ENACRobotique/Cartes_Base_roulante/README.md

# Carte_Base_roulante_2024
Carte custom pour une base roulante holonome basé sur la STM32G484Retx
Conçue pour d'elle même faire de l'odométrie par encodeur et gyroscope.
Le debug nécéssite une sonde externe.
