ENACRobotique/Cartes_Base_roulante/Brushless/Composants.md

## Liste de composants Brushless (avec références RS)

### Capacités:
- **0603** :
  - 100n x8
  - 4.7u
  - 10n
  - 470n
  - 1u x2
  - 10u x 4 : 766-1104
- **100u** : 135-9884

### Résistances:
- **0805** :
  - 120 x2
  - 10k x2
  - 53k
  - osef x3 (R-LED)
  - 40k
- **0603** :
  - 5.1k x2

### Diodes:
- **Diode SOD 123W x3** : Nexperia_CFP3_SOD-123W
- **LED 0603 x2** : LED_0603_1608Metric_Pad1.05x0.95mm_HandSolder
- **LED 0603**
- **Zener SOD 523**

### Quartz:
- **ASCO** : [rs 171-2862](https://fr.rs-online.com/web/p/oscillateurs-a-quartz/1712862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) [fn 3573056](https://fr.farnell.com/abracon/asco-8-000mhz-ek-t3/oscillateur-8mhz-cmos-1-6mm-x/dp/3573056)

### MOSFET:
- **IRF7424PbF SOIC-8 (or IRF7404PbF)** : [178-1525](https://fr.rs-online.com/web/p/transistors-mosfet/1781525) !!! [OBSOLETE](https://www.mouser.fr/ProductDetail/Infineon-Technologies/IRF7404PBF?qs=viZOYRqmkgHi8AOJUtYoMQ%3D%3D) !!!

### Autres composants:
- **Bouton** : [378-6325](https://fr.rs-online.com/web/p/interrupteurs-tactiles/3786325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)
- **IMU** : LSM6DSL - [1639811](https://fr.rs-online.com/web/p/capteurs-de-mouvement/1639811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)

### Transformateurs :
- **LM3940IMP-3.3** : [197-7281](https://fr.rs-online.com/web/p/regulateurs-de-tension/1977281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)
- **R-78E-1.0** : [144-6290](https://fr.rs-online.com/web/p/regulateurs-a-decoupage/1446290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)

### Connecteurs :
- **Molex** :
  - x1 Molex_PicoBlade_53398-0571_1x05-1MP_P1.25mm_Vertical
  - x4 Molex_PicoBlade_53398-0371_1x03-1MP_P1.25mm_Vertical
- **USB-C** : [HRO_C-31-M-12](https://www.lcsc.com/product-detail/USB-Type-C_Korean-Hroparts-Elec-TYPE-C-31-M-12_C165948.html)
- AMASS_**XT30**UPB x3 : ( à changer pour la prochaine itération ) [4220277](https://fr.farnell.com/multicomp-pro/mp011752/conn-puiss-rect-male-2-voies-pcb/dp/4220277) et [4220278](https://fr.farnell.com/multicomp-pro/mp011753/conn-puiss-rect-fem-2-voies-pcb/dp/4220278#anchorTechnicalDOCS)
- **Bornier 2_P5.08mm** : [790-1064](https://fr.rs-online.com/web/p/borniers-pour-circuits-imprimes/7901064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)

### Puces :
- **STM32G484RET6 LQFP-64** : [193-9866](https://fr.rs-online.com/web/p/microcontroleurs/1939866?searchId=190ac068-da62-4743-bb04-424adfd3cdd6&gb=s)
- **TCAN332G SOT-23-8** : FABIEN
