ENACRobotique/Cartes_Base_roulante/Brushless/CarteBrushless.kicad_pcb

## KiCad design Brushless/CarteBrushless.kicad_pcb (2025-02-13)

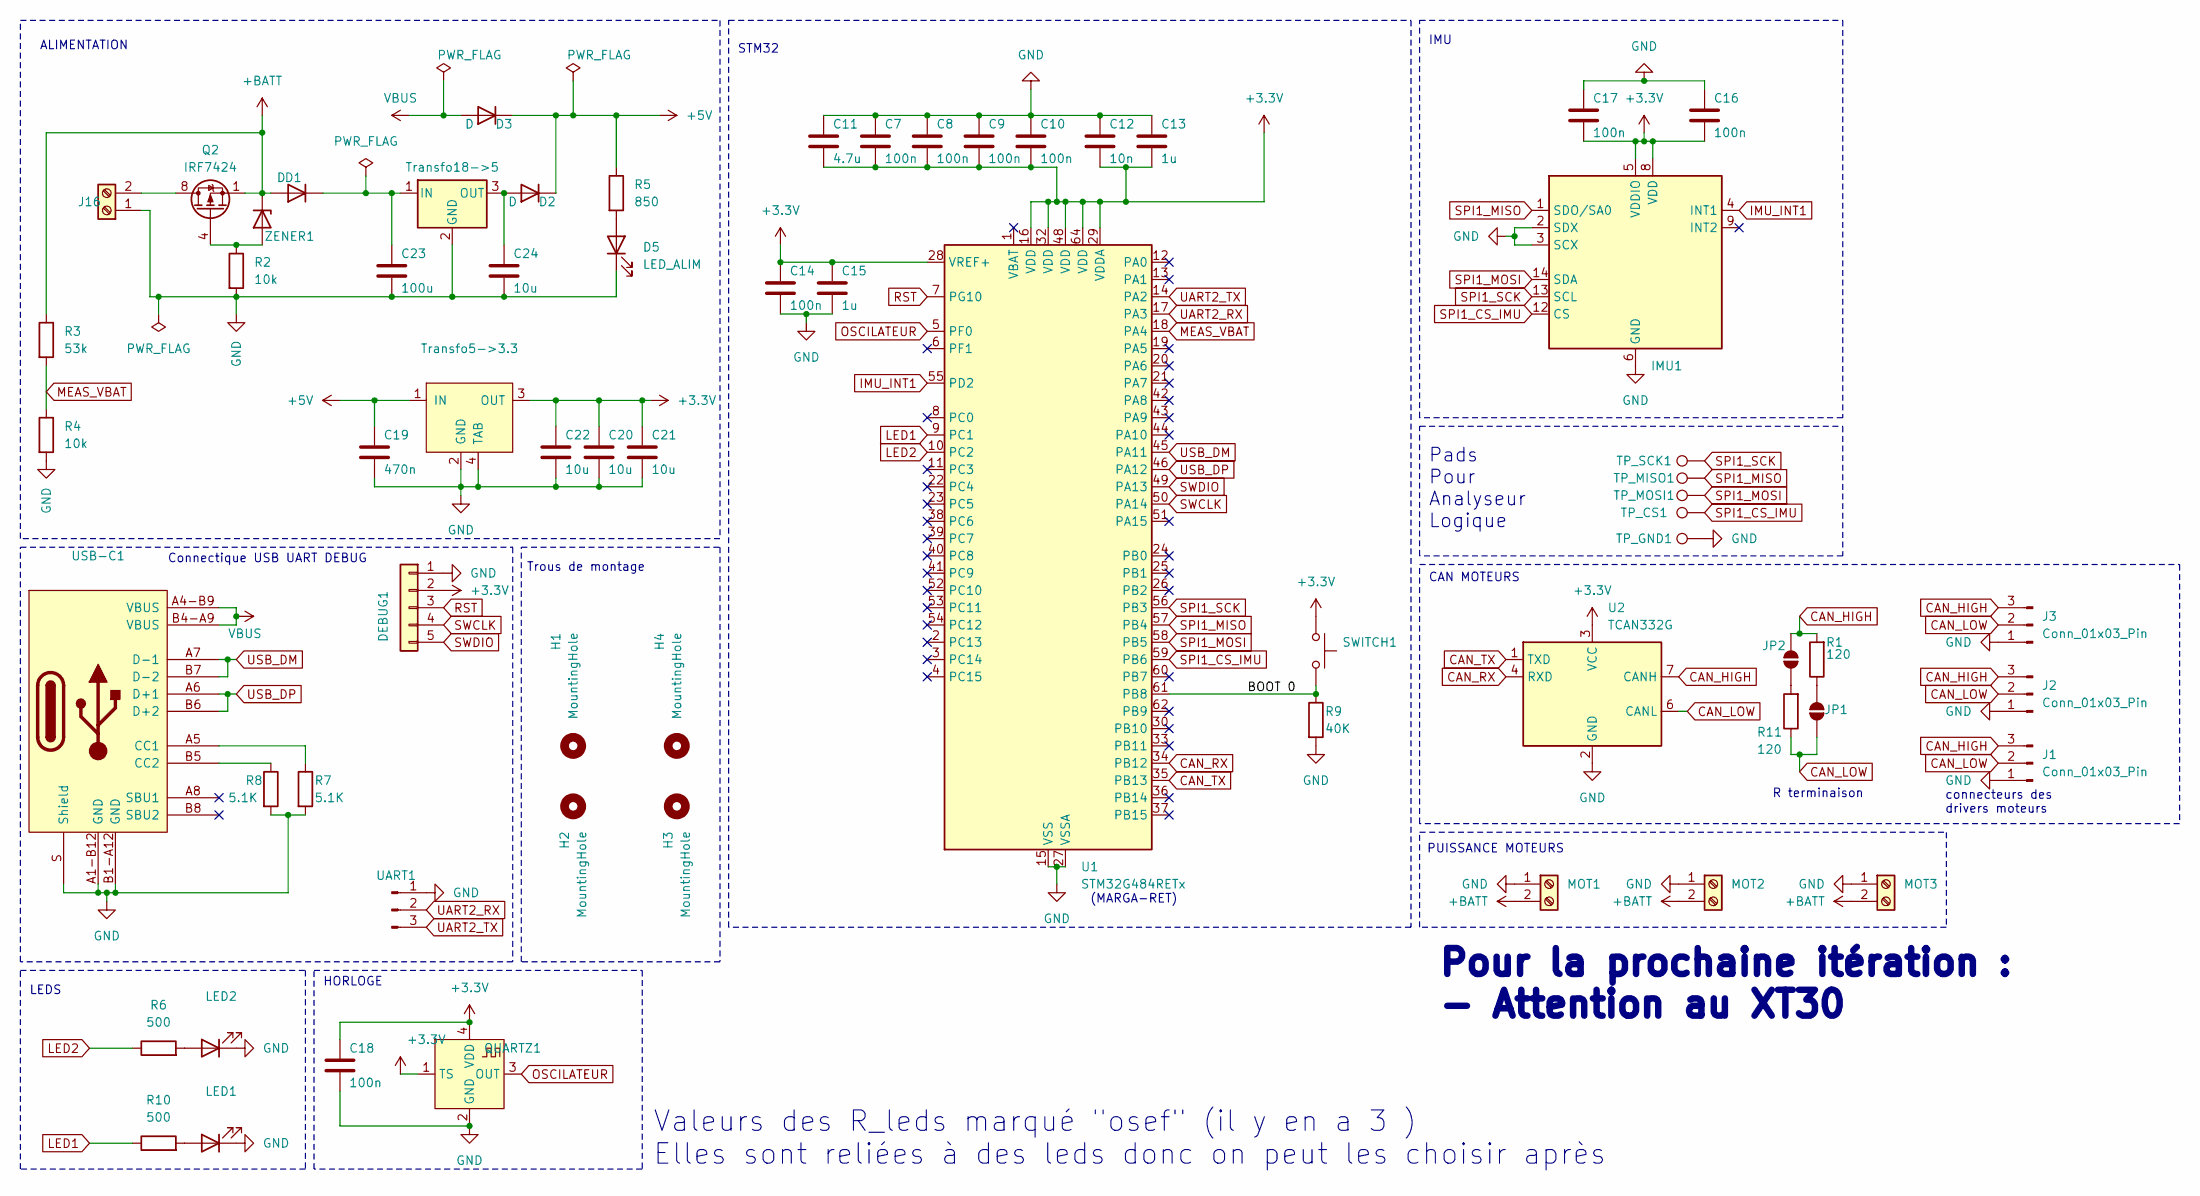
[picture p1: schematic CarteBrushless.kicad_sch]

Parts:
C7, C8, C9, C10, C14, C16, C17, C18: 100n; C_0603_1608Metric
C11: 4.7u; C_0603_1608Metric
C12: 10n; C_0603_1608Metric
C13, C15: 1u; C_0603_1608Metric
C19: 470n; C_0603_1608Metric
C20, C21, C22, C24: 10u; C_0603_1608Metric
C23: 100u; CP_EIA-7343-31_Kemet-D_Pad2.25x2.55mm_HandSolder
D1, D2, D3: D; Nexperia_CFP3_SOD-123W
D5: LED_ALIM; LED_0603_1608Metric
DEBUG1: DEBUG; Molex_PicoBlade_53398-0571_1x05-1MP_P1.25mm_Vertical
H1, H2, H3, H4: MountingHole; MountingHole_3.2mm_M3
IMU1: LSM6DSL; LGA-14_3x2.5mm_P0.5mm_LayoutBorder3x4y
J1, J2, J3: Conn_01x03_Pin; Molex_PicoBlade_53398-0371_1x03-1MP_P1.25mm_Vertical
J16: ALIM; TerminalBlock_bornier-2_P5.08mm
JP1, JP2: SolderJumper_2_Open; SolderJumper-2_P1.3mm_Open_RoundedPad1.0x1.5mm
LED1: LED1; LED_0603_1608Metric_Pad1.05x0.95mm_HandSolder
LED2: LED2; LED_0603_1608Metric_Pad1.05x0.95mm_HandSolder
MOT1, MOT2, MOT3: MOT3; AMASS_XT30UPB-F_1x02_P5.0mm_Vertical
Q2: IRF7424; SOIC-8_3.9x4.9mm_P1.27mm
QUARTZ1: ASCO; Osc_ASCO
R1, R11: 120; R_0805_2012Metric
R2, R4: 10k; R_0805_2012Metric
R3: 53k; R_0805_2012Metric
R5: 850; R_0805_2012Metric
R6, R10: 500; R_0805_2012Metric
R7, R8: 5.1K; R_0603_1608Metric
R9: 40K; R_0805_2012Metric
SWITCH1: SW_Push; SWITCH_DTSM31NV
TP_CS1: TestPoint; TestPoint_Pad_D1.5mm
TP_GND1: TestPoint; TestPoint_Pad_D1.5mm
TP_MISO1: TestPoint; TestPoint_Pad_D1.5mm
TP_MOSI1: TestPoint; TestPoint_Pad_D1.5mm
TP_SCK1: TestPoint; TestPoint_Pad_D1.5mm
Transfo5->3.3: LM3940IMP-3.3; LM3940IMP
Transfo18->5: R-78E5.0-1.0; Converter_DCDC_RECOM_R-78E-0.5_THT
U1: STM32G484RETx; LQFP-64_10x10mm_P0.5mm
U2: TCAN332G; SOT-23-8
UART1: Conn_01x03_Pin; Molex_PicoBlade_53398-0371_1x03-1MP_P1.25mm_Vertical
USB-C1: USB-C_12pin; USB-C_HRO_C-31-M-12
ZENER1: D_Zener; D_SOD-523

Connections:
+3.3V: C7.2, C8.2, C9.2, C10.2, C11.2, C12.2, C13.2, C14.1, C15.1, C16.2, C17.2, C18.1, C20.1, C21.1, C22.1, DEBUG1.2, IMU1.5 (VDDIO), IMU1.8 (VDD), QUARTZ1.1 (TS), QUARTZ1.4 (VDD), SWITCH1.1, Transfo5->3.3.3 (OUT), U1.16 (VDD), U1.28 (VREF+), U1.29 (VDDA), U1.32 (VDD), U1.48 (VDD), U1.64 (VDD), U2.3 (VCC)
+5V: C19.1, D2.1 (K), D3.1 (K), R5.1, Transfo5->3.3.1 (IN)
+BATT: D1.2 (A), MOT1.2, MOT2.2, MOT3.2, Q2.1 (S), Q2.2 (S), Q2.3 (S), R3.1, ZENER1.1 (K)
/BOOT 0: R9.1, SWITCH1.2, U1.61 (PB8)
CAN_HIGH: J1.3, J2.3, J3.3, JP2.2 (B), R1.2, U2.7 (CANH)
CAN_LOW: J1.2, J2.2, J3.2, JP1.1 (A), R11.1, U2.6 (CANL)
CAN_RX: U1.34 (PB12), U2.4 (RXD)
CAN_TX: U1.35 (PB13), U2.1 (TXD)
GND: C7.1, C8.1, C9.1, C10.1, C11.1, C12.1, C13.1, C14.2, C15.2, C16.1, C17.1, C18.2, C19.2, C20.2, C21.2, C22.2, C23.2, C24.2, D5.1 (K), DEBUG1.1, IMU1.2 (SDX), IMU1.3 (SCX), IMU1.6 (GND), IMU1.7 (GND), J1.1, J2.1, J3.1, LED1.1 (K), LED2.1 (K), MOT1.1, MOT2.1, MOT3.1, QUARTZ1.2 (GND), R2.2, R4.2, R7.2, R8.2, R9.2, TP_GND1.1, Transfo5->3.3.2 (GND), Transfo5->3.3.4 (TAB), Transfo18->5.2 (GND), U1.15 (VSS), U1.27 (VSSA), U1.31 (VSS), U1.47 (VSS), U1.63 (VSS), U2.2 (GND), UART1.1, USB-C1.A1-B12 (GND), USB-C1.B1-A12 (GND), USB-C1.S (Shield); also elsewhere on the board
IMU_INT1: IMU1.4 (INT1), U1.55 (PD2)
LED1: R10.1, U1.9 (PC1)
LED2: R6.1, U1.10 (PC2)
MEAS_VBAT: R3.2, R4.1, U1.18 (PA4)
unnamed 13: Q2.5 (D), Q2.6 (D), Q2.7 (D), Q2.8 (D); also elsewhere on the board
unnamed: C23.1, D1.1 (K), Transfo18->5.1 (IN)
unnamed: C24.1, D2.2 (A), Transfo18->5.3 (OUT)
unnamed: D5.2 (A), R5.2
unnamed: JP1.2 (B), R1.1
unnamed: JP2.1 (A), R11.2
unnamed: LED1.2 (A), R10.2
unnamed: LED2.2 (A), R6.2
unnamed: Q2.4 (G), R2.1, ZENER1.2 (A)
unnamed: R7.1, USB-C1.A5 (CC1)
unnamed: R8.1, USB-C1.B5 (CC2)
OSCILATEUR: QUARTZ1.3 (OUT), U1.5 (PF0)
RST: DEBUG1.3, U1.7 (PG10)
SPI1_CS_IMU: IMU1.12 (CS), TP_CS1.1, U1.59 (PB6)
SPI1_MISO: IMU1.1 (SDO/SA0), TP_MISO1.1, U1.57 (PB4)
SPI1_MOSI: IMU1.14 (SDA), TP_MOSI1.1, U1.58 (PB5)
SPI1_SCK: IMU1.13 (SCL), TP_SCK1.1, U1.56 (PB3)
SWCLK: DEBUG1.4, U1.50 (PA14)
SWDIO: DEBUG1.5, U1.49 (PA13)
UART2_RX: U1.17 (PA3), UART1.2
UART2_TX: U1.14 (PA2), UART1.3
USB_DM: U1.45 (PA11), USB-C1.A7 (D-1), USB-C1.B7 (D-2)
USB_DP: U1.46 (PA12), USB-C1.A6 (D+1), USB-C1.B6 (D+2)
VBUS: D3.2 (A), USB-C1.A4-B9 (VBUS), USB-C1.B4-A9 (VBUS)

Notes on the sheet:
Valeurs des R_leds marqué "osef" (il y en a 3 ) Elles sont reliées à des leds donc on peut les choisir après
IMU
LEDS
Trous de montage
connecteurs des drivers moteurs
CAN MOTEURS
HORLOGE
Pour la prochaine itération : - Attention au XT30
(MARGA-RET)
Pads Pour Analyseur Logique
PUISSANCE MOTEURS
STM32
ALIMENTATION
R terminaison
Connectique USB UART DEBUG

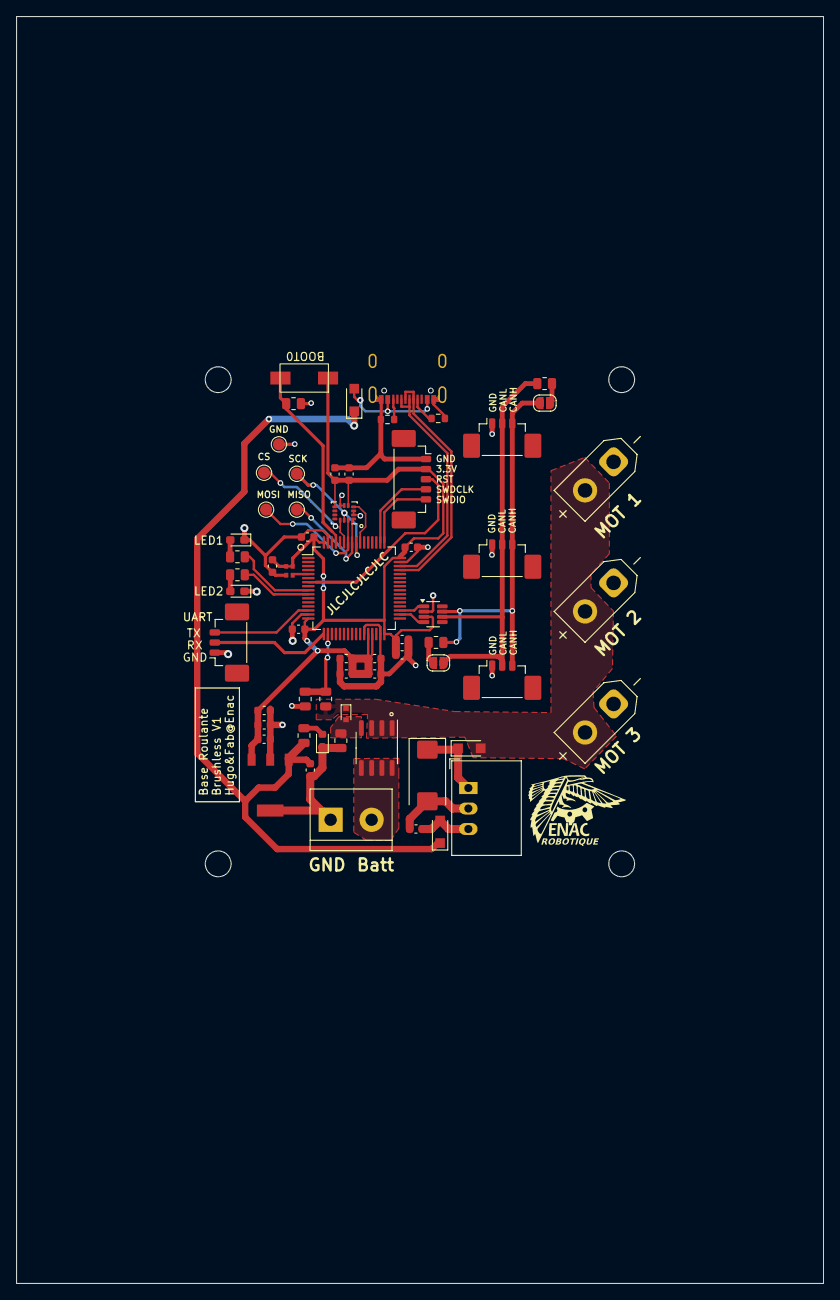
[picture p2: board CarteBrushless.kicad_pcb from above]

Board: 2 copper layers, 100.0 x 157.0 mm, 65 parts (0 on the bottom side), 37 nets.

Other parts of the board:
ALIM1: ALIM; TerminalBlock_bornier-2_P5.08mm

Their connections:
GND: ALIM1.1; also elsewhere on the board
unnamed 13: ALIM1.2; also elsewhere on the board
