ENACRobotique/Cartes_Base_roulante/Brushless/CarteBrushless.ioc

Mcu.UserName=STM32G484RETx
PA11.Signal=USB_DM
PA12.Signal=USB_DP
PA13.Signal=SYS_JTMS-SWDIO
PA14.Signal=SYS_JTCK-SWCLK
PA2.Signal=USART2_TX
PA3.Signal=USART2_RX
PA4.Signal=ADC2_IN17
PB12.Signal=FDCAN2_RX
PB13.Signal=FDCAN2_TX
PB3.Signal=SPI1_SCK
PB4.Signal=SPI1_MISO
PB5.Signal=SPI1_MOSI
PB6.GPIO_Label=SPI1_CS_IMU
PB6.Signal=GPIO_Output
PB8-BOOT0.GPIO_Label=BOOT0
PB8-BOOT0.Signal=GPIO_Input
PC1.GPIO_Label=LED1
PC1.Signal=GPIO_Output
PC10.Signal=UART4_TX
PC11.Signal=UART4_RX
PC2.GPIO_Label=LED2
PC2.Signal=GPIO_Output
PD2.GPIO_Label=IMU_INT1
PD2.Signal=GPIO_Input
PF0-OSC_IN.Signal=RCC_OSC_IN
PG10-NRST.GPIO_Label=RST
PG10-NRST.Signal=GPIO_Input
