ENACRobotique/Cartes_Base_roulante/(commit log)

2023-11-22 add capacitors
    [Carte_Base_roulante_2024.kicad_sch]
2023-11-23 IMU + SPI
    [Carte_Base_roulante_2024.kicad_sch]
2023-11-23 usb + protection + cristal + leds + adc
    [Carte_Base_roulante_2024.kicad_sch]
2023-11-23 add testpoints for SPI
    [Carte_Base_roulante_2024.kicad_sch]
2023-11-24 ajout empreintes wip
    [Carte_Base_roulante_2024.kicad_sch]
2023-11-25 placement préliminaire
    [Carte_Base_roulante_2024.kicad_pcb, Carte_Base_roulante_2024.kicad_sch]
2023-11-26 compact : alim, encodeur, imu
    [Carte_Base_roulante_2024.kicad_pcb, Carte_Base_roulante_2024.kicad_sch]
2023-11-30 placement amélioré
    [Carte_Base_roulante_2024.kicad_pcb, Carte_Base_roulante_2024.kicad_sch]
2023-11-30 changement alim et plan BATT
    [Carte_Base_roulante_2024.kicad_pcb]
2023-12-01 + batt ok ?
    [Carte_Base_roulante_2024.kicad_pcb]
2023-12-01 routage avançé
    [Carte_Base_roulante_2024.kicad_pcb, Carte_Base_roulante_2024.kicad_sch]
2023-12-01 manque plan GNA et pads
    [Carte_Base_roulante_2024.kicad_pcb]
2023-12-01 almost ended , need GND
    [Carte_Base_roulante_2024.csv, Carte_Base_roulante_2024.kicad_pcb, Carte_Base_roulante_2024.kicad_sch]
2023-12-02 Routage Terminé git status !
    [Carte_Base_roulante_2024.kicad_pcb]
2023-12-02 j'ai pas fait Ctrl S ...
    [Carte_Base_roulante_2024.kicad_pcb, Carte_Base_roulante_2024.kicad_sch]
2023-12-04 Carte terminé git status!
    [Carte_Base_roulante_2024.kicad_pcb, Carte_Base_roulante_2024.kicad_sch]
2023-12-05 ajuste espacement trous
    [Carte_Base_roulante_2024.kicad_pcb]
2023-12-05 corrections + courbe + stencil
    [Carte_Base_roulante_2024.kicad_pcb]
2023-12-07 fix DRC
    [Carte_Base_roulante_2024.kicad_pcb]
2024-02-02 production attention stencil trop grand de quelques mm
    [Carte_Base_roulante_2024-B_Cu.gbr, Carte_Base_roulante_2024-B_Mask.gbr, Carte_Base_roulante_2024-B_Paste.gbr, Carte_Base_roulante_2024-B_SilkS.gbr, Carte_Base_roulante_2024-Edge_Cuts.gbr, Carte_Base_roulante_2024-F_Cu.gbr, Carte_Base_roulante_2024-F_Mask.gbr, Carte_Base_roulante_2024-F_Paste.gbr]
2024-12-19 rangement du repo
    [CarteBrushless.kicad_pcb, CarteBrushless.kicad_sch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]
2024-12-19 Schematic Brushless
    [CarteBrushless.kicad_sch]
2024-12-19 tentative de fix du bug de reset
    [CarteBrushless.kicad_sch]
2024-12-19 placement PCB
    [CarteBrushless.kicad_pcb, CarteBrushless.kicad_sch]
2024-12-20 Routage fini
    [CarteBrushless.kicad_pcb, CarteBrushless.kicad_sch]
2024-12-20 Pad BATT+ Solides
    [CarteBrushless.kicad_pcb]
2025-01-23 change SWD footprint
    [CarteBrushless.kicad_pcb, CarteBrushless.kicad_sch]
2025-01-23 Reduce mounting holes spacing
    [CarteBrushless.kicad_pcb]
2025-01-23 Ajustement des trous
    [CarteBrushless.kicad_pcb]
2025-01-23 Gerber et stencil
2025-01-24 save stencil
    [CarteBrushless.kicad_pcb]
2025-02-06 liste des composants
    [CarteBrushless.kicad_sch]
2025-02-13 resistance LED + schema soudure
    [CarteBrushless.kicad_pcb, CarteBrushless.kicad_sch]
